roblatour/BlueKeyRemote/BlueKeyRemote/Pictures/2 - board assembled.jpg

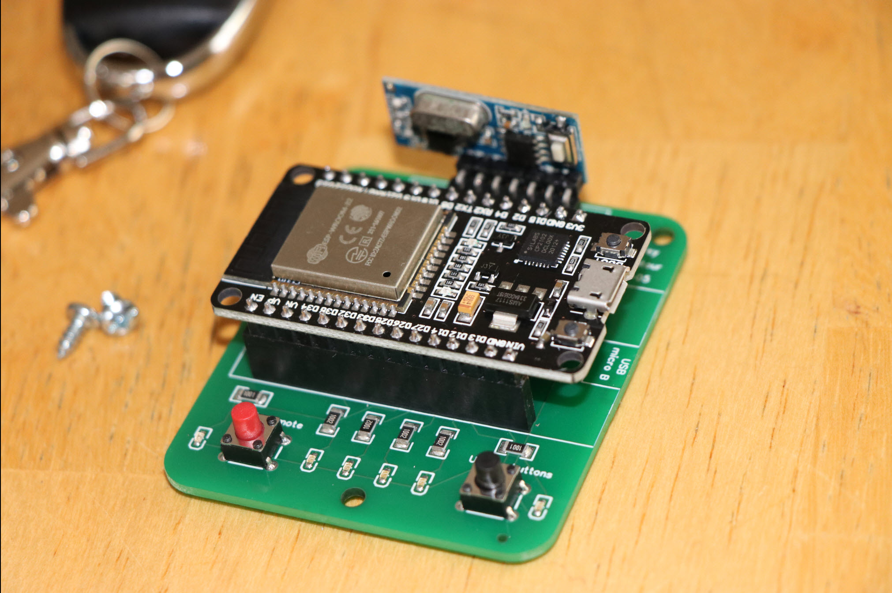
BlueKeyRemote/Pictures/2 - board assembled.jpg
