roblatour/BlueKeyRemote/BlueKeyRemote/Pictures/1 - parts.jpg

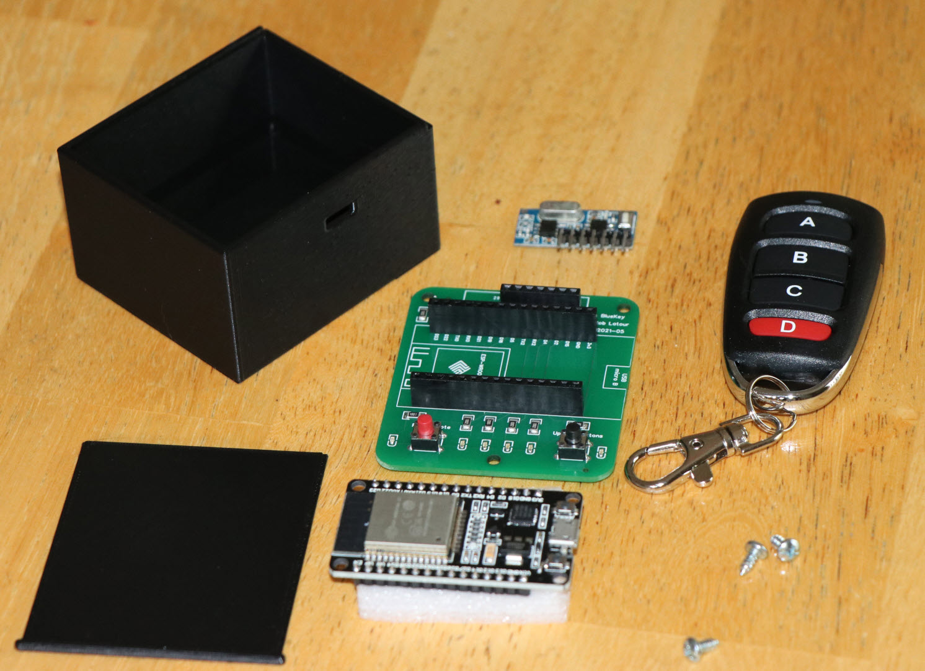
BlueKeyRemote/Pictures/1 - parts.jpg
