roblatour/BlueKeyRemote/README.md

# BlueKeyRemote
 Control your computer with a four button remote control.
 
 More info here: https://hackaday.io/project/180235-bluekey-remote
 
 Vidoe here: https://www.youtube.com/watch?v=vFP4XjahP48
 
 PCB here: https://oshwlab.com/RobLatour/bluekeyremote
 
 3D printed enclosure here: https://www.thingiverse.com/thing:4881425
 
## Support

[buy me a coffee](https://www.buymeacoffee.com/roblatour)
