roblatour/BlueKeyRemote/BlueKeyRemote/pcb.jpg

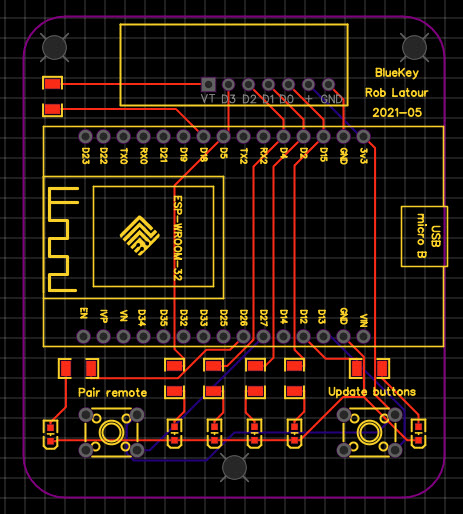
BlueKeyRemote/pcb.jpg
