roblatour/BlueKeyRemote/BlueKeyRemote/Pictures/3 - in box.jpg

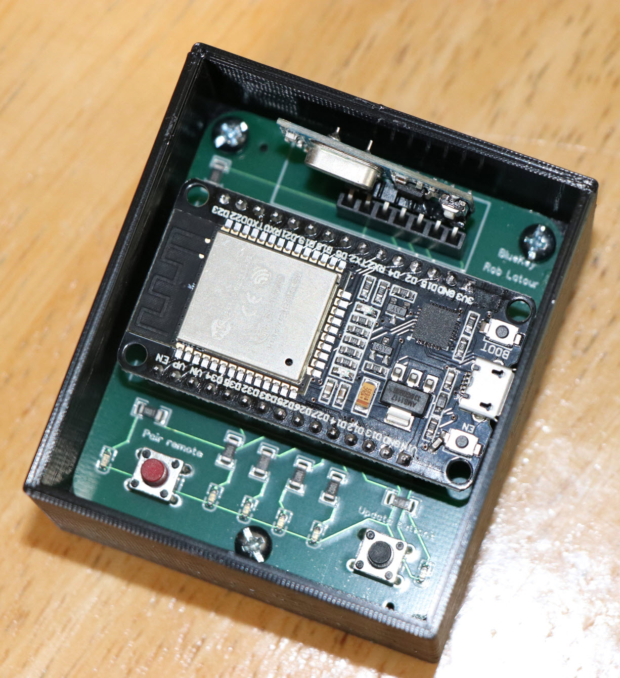
BlueKeyRemote/Pictures/3 - in box.jpg
