roblatour/BlueKeyRemote/BlueKeyRemote/Pictures/4 - box semi closed.jpg

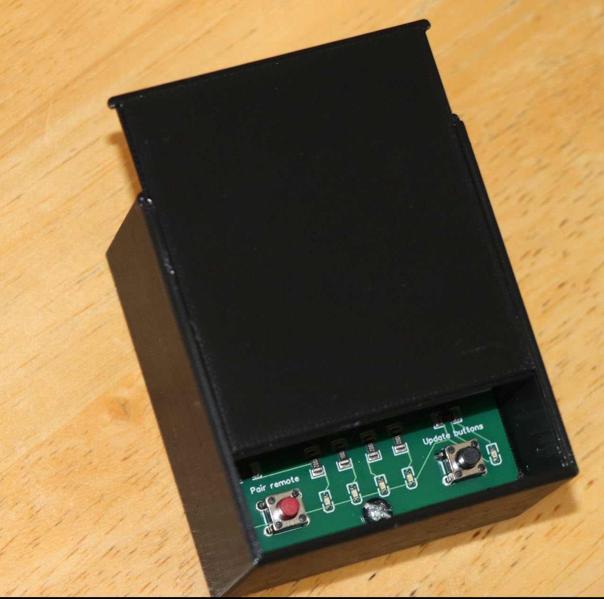
BlueKeyRemote/Pictures/4 - box semi closed.jpg
