roblatour/BlueKeyRemote/BlueKeyRemote/Pictures/5 - closed box.jpg

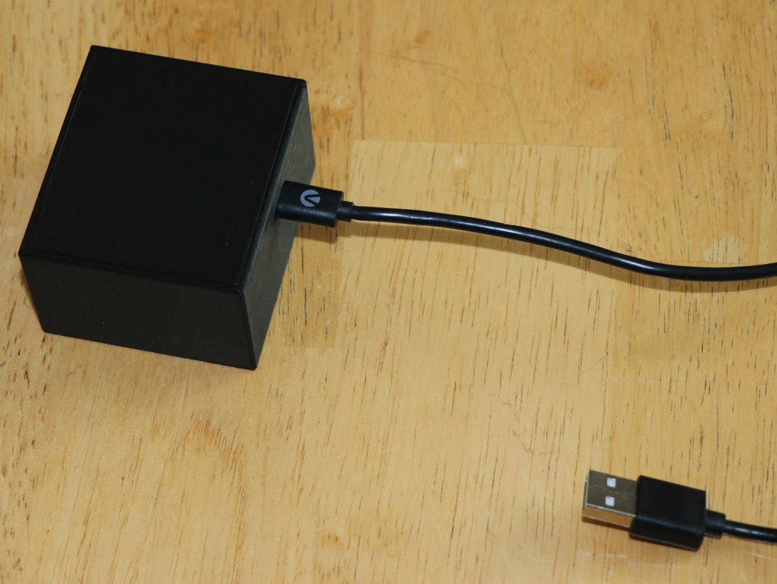
BlueKeyRemote/Pictures/5 - closed box.jpg
