roblatour/BlueKeyRemote/BlueKeyRemote/schematic.jpg

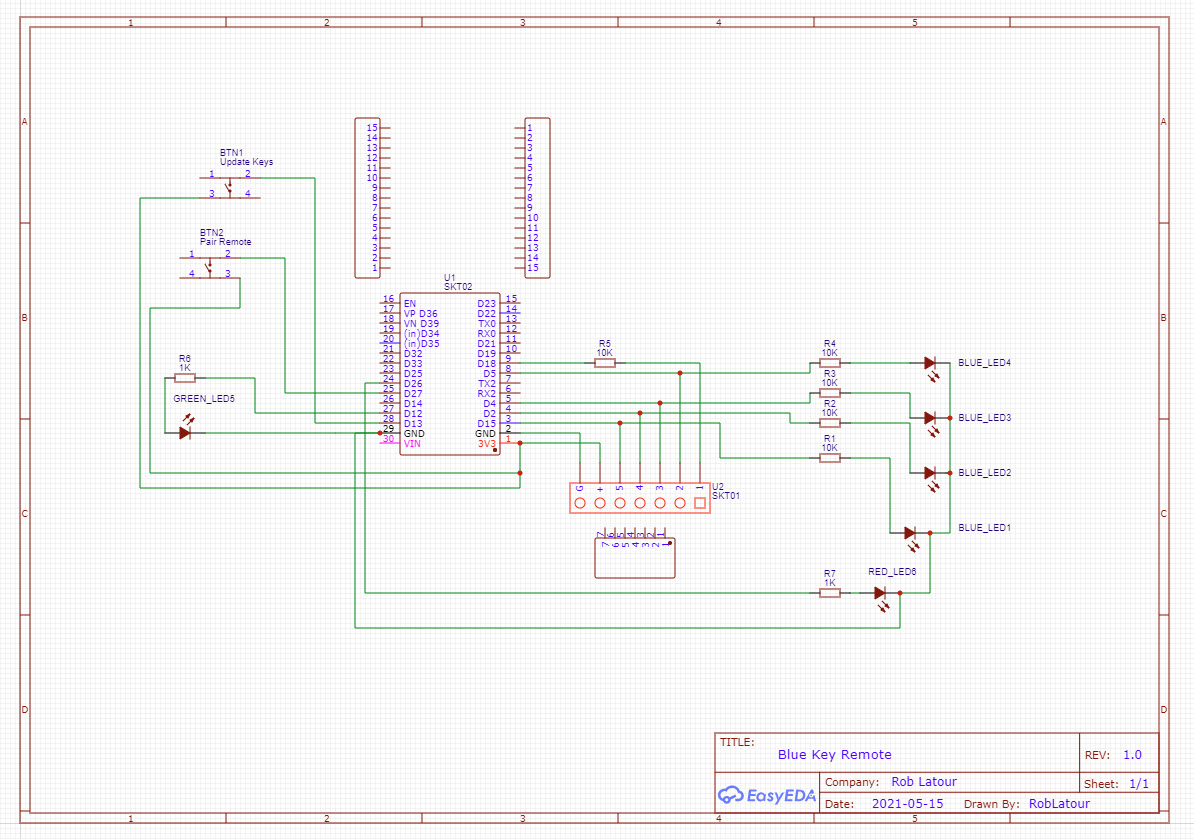
BlueKeyRemote/schematic.jpg
