roblatour/BlueKeyRemote/(commit log)

2021-06-08 initial commit
    ESP32 project that lets you control your computer with a four button remote
2021-06-08 update .ino with link to pcb
    added link to pcb
2021-06-08 Update BlueKeyRemoteV1.ino
    added link to 3d printable enclosure
2021-06-09 Update BlueKeyRemoteV1.ino
    update comments
    change button hold down time during pairing to 1.5 seconds from 1 second
2021-07-03 updates for Arduino 1.8.15
    Updates to provide compatibility with Arduino 1.8.15. Note reference to patch also needed to the BLEKeyboard library (linked to from Misc folder)
